inaneda/room-monitor/images/thingspeak (1).png

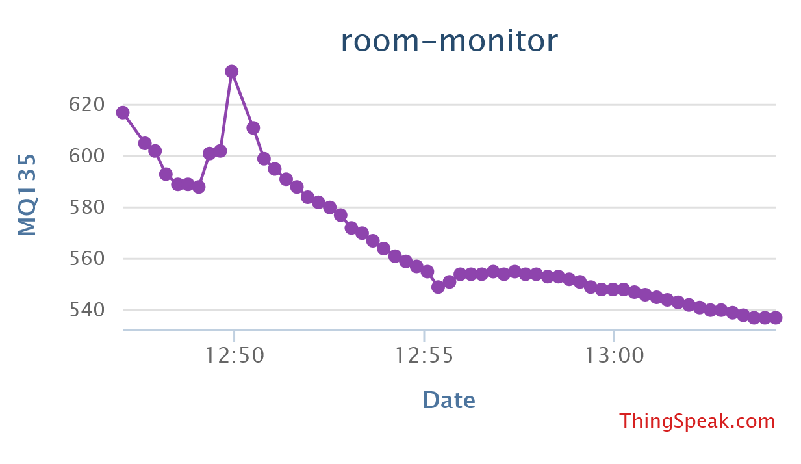
images/thingspeak (1).png
