inaneda/room-monitor/images/thingspeak (2).png

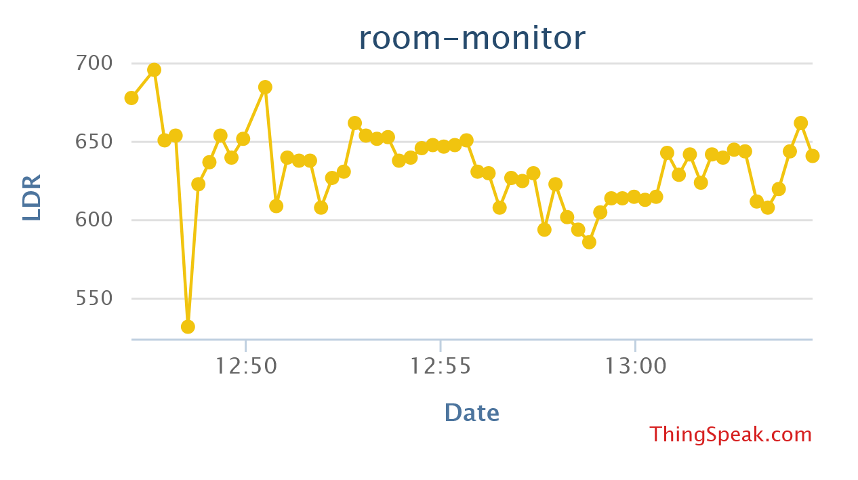
images/thingspeak (2).png
