inaneda/room-monitor/images/thingspeak (3).png

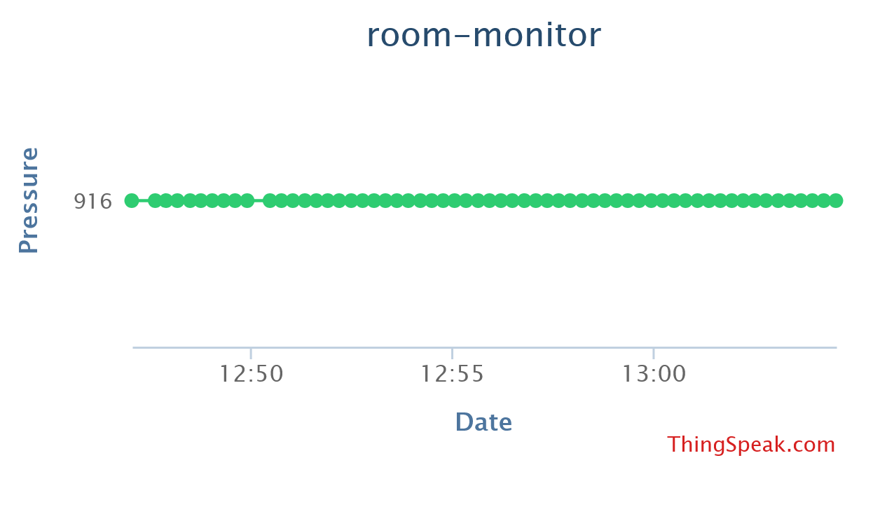
images/thingspeak (3).png
