inaneda/room-monitor/images/thingspeak (4).png

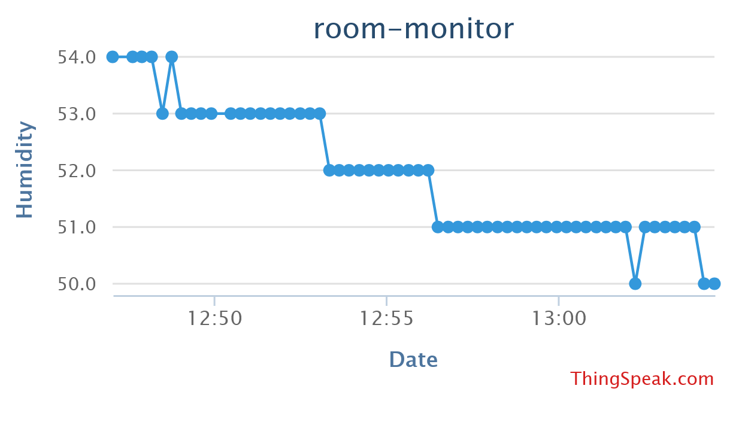
images/thingspeak (4).png
