inaneda/room-monitor/images/thingspeak (5).png

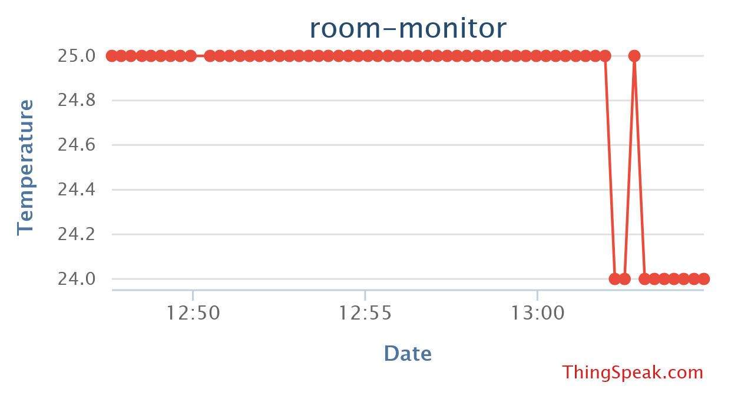
images/thingspeak (5).png
