inaneda/room-monitor/code/atmega328p/secrets.h

/*
 * secrets.h
 *
 * Created: 16.04.2026 02:56:53
 *  Author: MSI
 */ 


#ifndef SECRETS_H_
#define SECRETS_H_

#define WIFI_SSID		"your_wifi_name"
#define WIFI_PASS		"your_wifi_password"
#define THINGSPEAK_KEY	"your_api_key"

#endif /* SECRETS_H_ */
