inaneda/room-monitor/(commit log)

2026-03-23 feat: GPIO LED and buzzer control
    [gpio.c, gpio.h, main.c]
2026-03-23 feat: ADC reading for LDR and MQ135, UART debug added
2026-03-23 feat: LCD display added, LED and buzzer threshold logic implemented
    [adc.h, i2c.c, i2c.h, lcd.c, lcd.h, main.c, uart.c]
2026-03-23 feat: BME280 added with Bosch calibration, LED buzzer threshold logic updated with temperature and humidity
    [bme280.c, bme280.h, main.c]
2026-04-16 refactor: split code into atmega328p/ and esp32/, update docs
